kiri0110/can_test/OneDrive/ドキュメント/Python/Attracts/can.md

sudo slcand -o -c -s2 /dev/ttyACM0 can0
sudo ip link set can0 up
