kiri0110/can_test/OneDrive/ドキュメント/PCB/446CAN_2-20240912T023128Z-001/446CAN_2/446CAN_2_readme.docx

446CAN_2_readme

kikad 7.0で作成（6.0では開けない）

446ハンバーガーの上側の基板

秋月B基板、両面ノンスルーホールで実装

真ん中のI2CピンはLCD用

RJ45の5VコネクタがST MorphoのU5Vピンと繋がっていないので、被覆線等でジャンプして適当に繋ぐ
