kiri0110/can_test/OneDrive/ドキュメント/PCB/303_MCv3_6-20240912T023711Z-001/303_MCv3_6/303MCv3.6パーツリスト.xlsx

品名 | 記号 | 定数・型番 | 数量 | 注 | 備考1 | 備考2
抵抗 | R1, R6, R8 |  | 3 | 1 | 黄色LEDに対応 | 2012又は1608サイズ
抵抗 | R2, R3, R9 |  | 3 | 1 | 緑色LEDに対応 | 2012又は1608サイズ
抵抗 | R4, R5, R7 |  | 3 | 1 | 赤色LEDに対応 | 2012又は1608サイズ
抵抗 | R10 | 120R | 1 |  | CANバスの終端抵抗用 | 2012又は1608サイズ
抵抗 | R11 |  | 1 | 1 | パイロットLED | 2012又は1608サイズ
抵抗 | R12 | 200R | 1 |  | Rg | 2012又は1608サイズ
抵抗 | R13 | 2K | 1 |  | Rgs | 2012又は1608サイズ
抵抗 | R14 | 100R | 1 |  | NRSTプルアップ | 2012又は1608サイズ
LED | D1, D6, D8 | 黄 | 3
LED | D4, D5, D7 | 赤 | 3
LED | D2, D3, D9 | 緑 | 3
LED | D10 | 青 | 1
ショットキーバリアダイオード | D11 | CUHS20S30 | 1
積層セラミックコンデンサ | C1 | 0.1uF | 1
FET | Q1 | 2N7002K | 1
スピーカー | LS1 | UGCT7525AN4 | 1
タクトスイッチ | SW1, SW2, SW3, SW5 | SKRPACE010 | 4 |  | 2.55N品を使用すること
スライドスイッチ | SW4 | SSSS213202 | 1
マイコン | U1 | NUCLEO-F303K8 | 1
CANトランシーバ | U2 | MCP2561-E-P | 1
ピンソケット | U1 | 分割ロングピンソケット42p | 19x2コマ
ICソケット | U2 | 2x4 | 1
ピンヘッダ | J1, J7, J13, J17 | ピンヘッダ2p | 2x4コマ
XAコネクタ | J2, J8, J11, J16 | B02B-XASK | 4
XAコネクタ | J5, J6, J14, J15 | B03B-XASK | 4
XAコネクタ | J3, J4 | B05B-XASK | 2
LANコネクタ | J9, J10 | RJ-45 | 2
GHコネクタ | J12, J18 | SM02B-GHS | 2
