kiri0110/can_test/OneDrive/ドキュメント/PCB/303_MCv3_6-20240912T023711Z-001/303_MCv3_6/BottomCase_C.stl

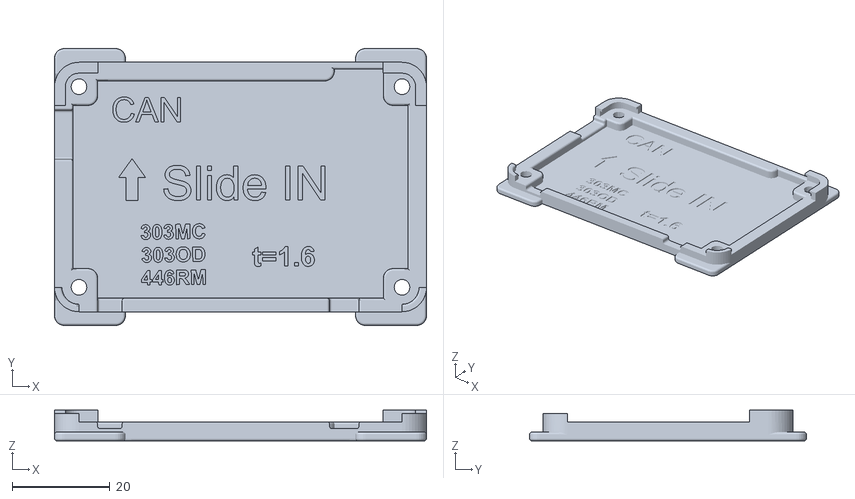
[picture p1: CAD file, 2025-05-26]
OneDrive/ドキュメント/PCB/303_MCv3_6-20240912T023711Z-001/303_MCv3_6/BottomCase_C.stl
76.0 x 56.6 x 6.30
