kiri0110/can_test/(list of files, cad)

Other CAD files:
OneDrive/ドキュメント/PCB/303_MCv3_6-20240912T023711Z-001/303_MCv3_6/BottomCase_Slide v3.step
