kiri0110/can_test/OneDrive/ドキュメント/PCB/303_MCv3_6-20240912T023711Z-001/303_MCv3_6/303MCv3.6_sch.pdf

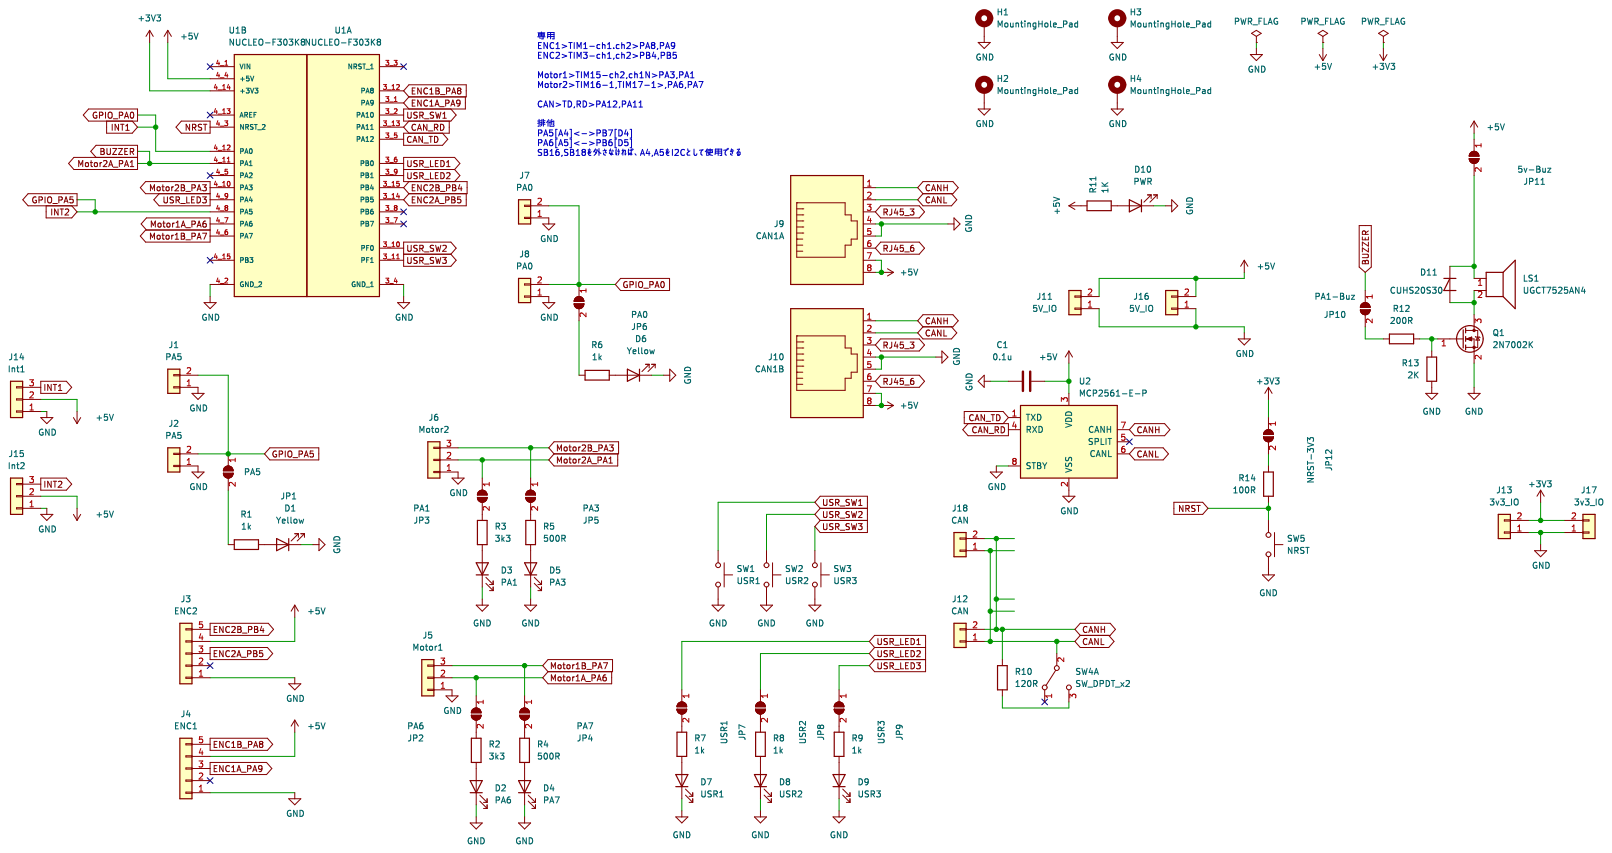
[picture p2: page 1]
