kiri0110/can_test/OneDrive/ドキュメント/PCB/446RMv1.0-20240913T070430Z-001/446RMv1.0/446_CAN_Robomaster_new.kicad_pcb

## KiCad design OneDrive/ドキュメント/PCB/446RMv1.0-20240913T070430Z-001/446RMv1.0/446_CAN_Robomaster_new.kicad_pcb (2025-05-26)

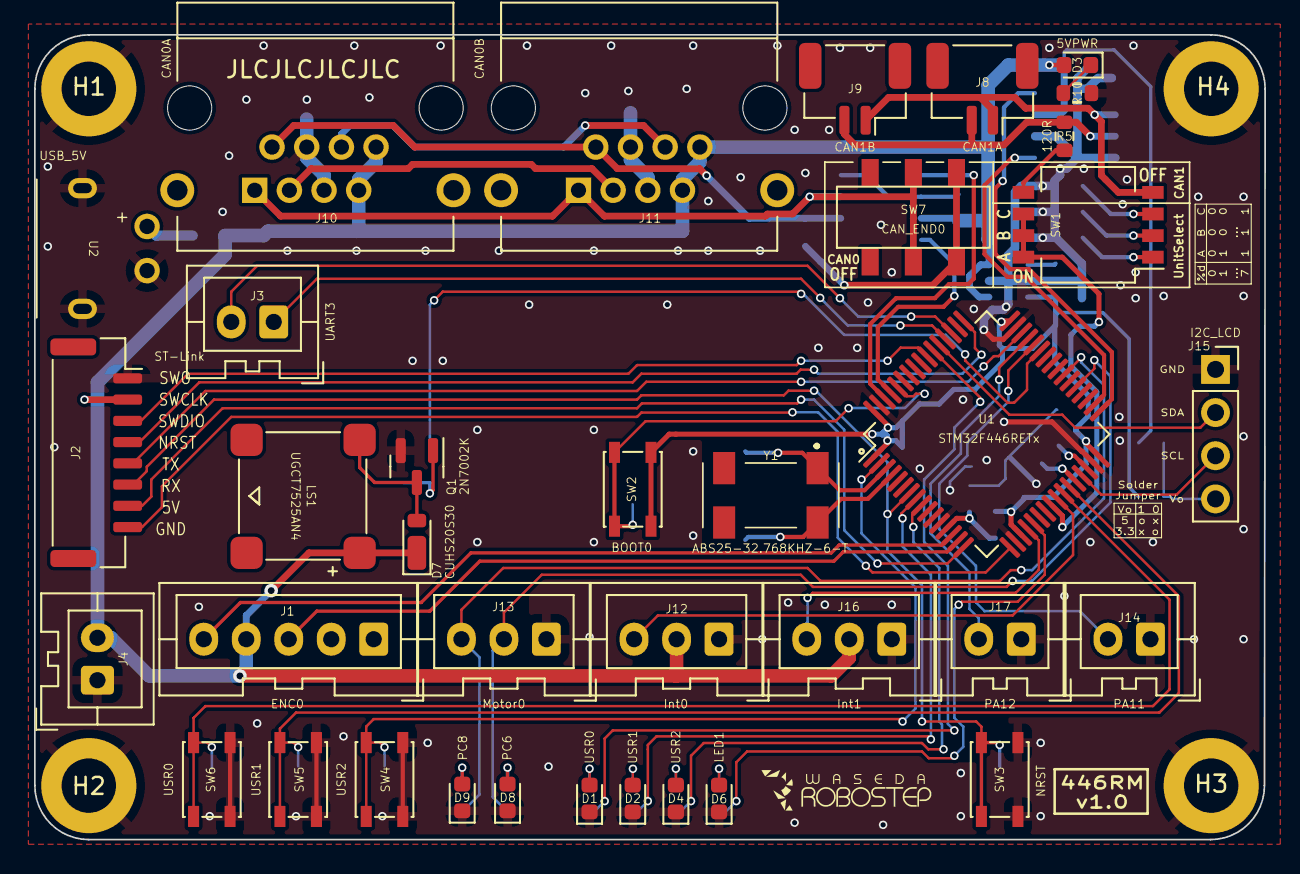
[picture p3: board 446_CAN_Robomaster_new.kicad_pcb from above]

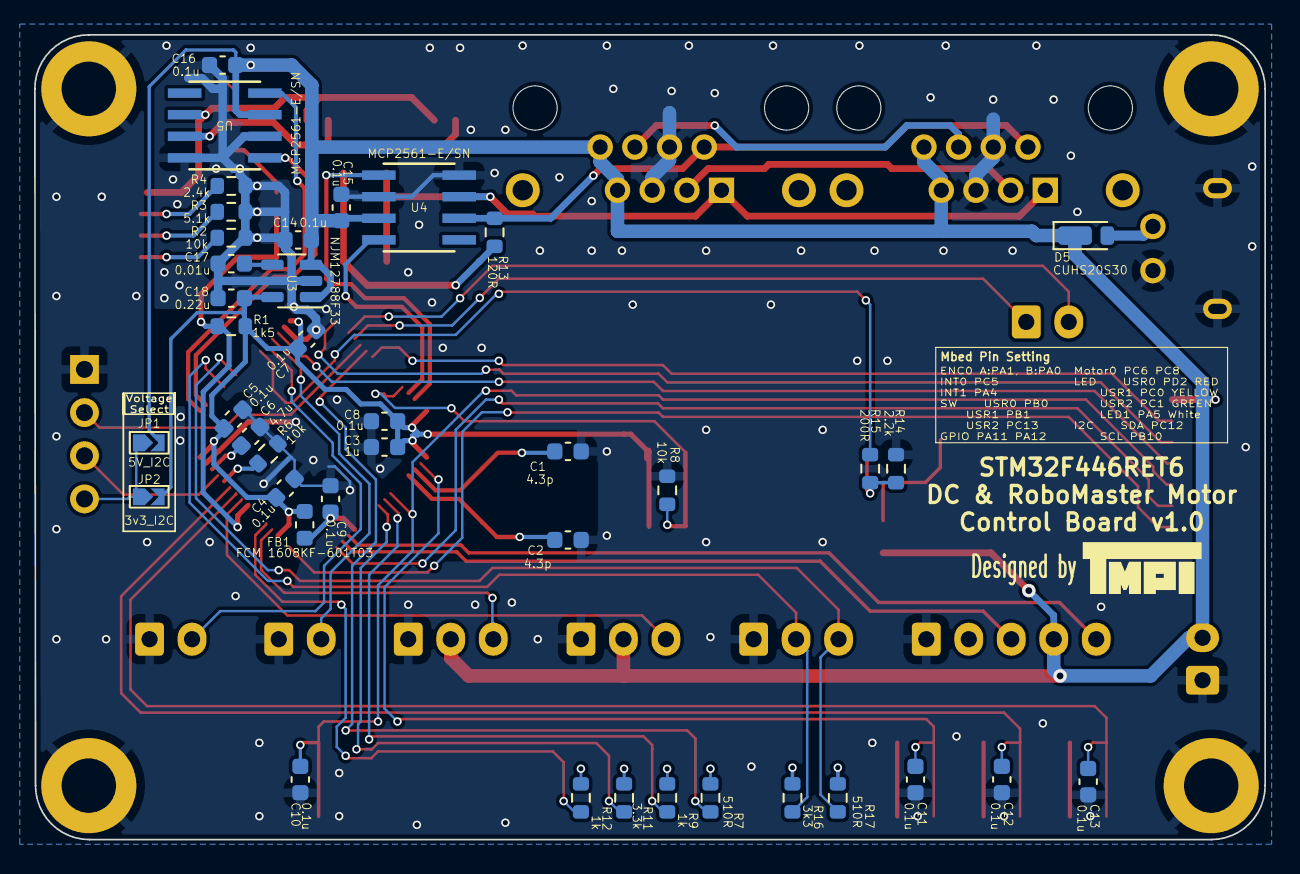
[picture p4: board 446_CAN_Robomaster_new.kicad_pcb from below]

Board: 2 copper layers, 72.4 x 47.3 mm, 80 parts (40 on the bottom side), 63 nets.

Parts:
C1, C2: 4.3p; C_0603_1608Metric
C3: 1u; C_0603_1608Metric
C4, C5, C7, C8, C9, C10, C11, C12, C13, C14, C15, C16: 0.1u; C_0603_1608Metric
C6: 4.7u; C_0603_1608Metric
C17: 0.01u; C_0603_1608Metric
C18: 0.22u; C_0603_1608Metric
D1: USR0; LED_0603_1608Metric
D2: USR1; LED_0603_1608Metric
D3: 5VPWR; LED_0603_1608Metric
D4: USR2; LED_0603_1608Metric
D5, D7: CUHS20S30; D_TUMD2
D6: LED1; LED_0603_1608Metric
D8: PC6; LED_0603_1608Metric
D9: PC8; LED_0603_1608Metric
FB1: FerriteBead; L_0603_1608Metric
H1, H2, H3, H4: H; MountingHole_3.2mm_M3_DIN965_Pad
J1: ENC0; JST_XA_B05B-XASK-1_1x05_P2.50mm_Vertical
J2: ST-Link; JST_GH_SM08B-GHS-TB_1x08-1MP_P1.25mm_Horizontal
J3: UART3; JST_XA_B02B-XASK-1_1x02_P2.50mm_Vertical
J4: 5V_IO; JST_XA_B02B-XASK-1_1x02_P2.50mm_Vertical
J8: CAN1A; JST_GH_SM02B-GHS-TB_1x02-1MP_P1.25mm_Horizontal_Handsolder
J9: CAN1B; JST_GH_SM02B-GHS-TB_1x02-1MP_P1.25mm_Horizontal_Handsolder
J10: CAN0A; Kai_LAN_RJ45_Neltron_Industrial_7810-8P8C
J11: CAN0B; Kai_LAN_RJ45_Neltron_Industrial_7810-8P8C
J12: Int0; JST_XA_B03B-XASK-1_1x03_P2.50mm_Vertical
J13: Motor0; JST_XA_B03B-XASK-1_1x03_P2.50mm_Vertical
J14: PA11; JST_XA_B02B-XASK-1_1x02_P2.50mm_Vertical
J15: I2C_LCD; PinSocket_1x04_P2.54mm_Vertical
J16: Int1; JST_XA_B03B-XASK-1_1x03_P2.50mm_Vertical
J17: PA12; JST_XA_B02B-XASK-1_1x02_P2.50mm_Vertical
JP1: 5V_I2C; solderbridge
JP2: 3v3_I2C; solderbridge
LS1: UGCT7525AN4
Q1: 2N7002K; SOT-23
R1: 1k5; R_0603_1608Metric
R2, R6, R8: 10k; R_0603_1608Metric
R3: 5.1k; R_0603_1608Metric
R4: 2.4k; R_0603_1608Metric
R5, R13: 120R; R_0603_1608Metric
R7, R17: 510R; R_0603_1608Metric
R9, R10, R12: 1k; R_0603_1608Metric
R11: 3.3k; R_0603_1608Metric
R14: 2.2k; R_0603_1608Metric
R15: 200R; R_0603_1608Metric
R16: 3k3; R_0603_1608Metric
SW1: UnitSelect; SW_DIP_SPSTx04_Slide_KingTek_DSHP04TS_W7.62mm_P1.27mm
SW2: BOOT0; SW_SPST_PTS810_HandSolder
SW3: NRST; SW_SPST_PTS810_HandSolder
SW4: USR2; SW_SPST_PTS810_HandSolder
SW5: USR1; SW_SPST_PTS810_HandSolder
SW6: USR0; SW_SPST_PTS810_HandSolder
SW7: CAN_END0; slide_SW
U1: STM32F446RETx; LQFP-64_10x10mm_P0.5mm
U2: USB_5V; aki_USB_mB_PWR
U3: NJM12788F33; SOT-23-5
U4, U5: MCP2561-E/SN; SOIC8-N_MC_MCH
Y1: ABS25-32.768KHZ-6-T; ABS2532768KHZT

Connections:
5V_CAN0: C14.1, C15.2, C16.2, D3.2 (A), D5.1 (K), D7.1 (K), J1.4, J2.2, J4.2, J10.7, J10.8, J11.7, J11.8, J12.2, J16.2, JP1.2 (B), LS1.1, U3.1 (VIN), U3.3 (CONTROL), U4.3 (VDD), U5.3 (VDD)
+3.3VA: C9.1, FB1.2, U1.13 (VDDA)
+3V3: C3.2, C4.1, C5.2, C7.1, C8.1, C18.1, FB1.1, JP2.2 (B), R1.1, SW2.1, U1.1 (VBAT), U1.19 (VDD), U1.32 (VDD), U1.48 (VDD), U1.64 (VDD), U3.5 (VOUT)
BOOT0: R8.2, SW2.2, U1.60 (BOOT0)
BUZZER: R15.1, U1.43 (PA10)
CAN_0+: J10.1, J11.1, SW7.2 (B), U4.7 (CANH)
CAN_0-: J10.2, J11.2, R13.2, U4.6 (CANL)
CAN_1+: J8.2, J9.2, R5.1, U5.7 (CANH)
CAN_1-: J8.1, J9.1, SW1.4, U5.6 (CANL)
CAN_RD_0: U1.61 (PB8), U4.4 (RXD)
CAN_RD_1: U1.33 (PB12), U5.4 (RXD)
CAN_TD_0: U1.62 (PB9), U4.1 (TXD)
CAN_TD_1: U1.34 (PB13), U5.1 (TXD)
ENC0A_PA1: J1.3, U1.15 (PA1)
ENC0B_PA0: J1.5, U1.14 (PA0)
GND: C1.2, C2.2, C3.1, C4.2, C5.1, C6.2, C7.2, C8.2, C9.2, C10.2, C11.2, C12.2, C13.2, C14.2, C15.1, C16.1, C17.2, C18.2, D1.1 (K), D2.1 (K), D4.1 (K), D6.1 (K), D8.1 (K), D9.1 (K), H1.1, H2.1, H3.1, H4.1, J1.1, J2.1, J4.1, J10.4, J10.5, J11.4, J11.5, J12.1, J13.1, J14.1, J15.1, J16.1, J17.1, Q1.2 (S), R2.2, R3.1, R4.1, R6.1, R8.1, R10.2, R14.1, SW3.2, SW4.2, SW5.2, SW6.2, U1.12 (VSSA), U1.18 (VSS), U1.31 (VSS), U1.47 (VSS), U1.63 (VSS), U2.2 (GND), U2.3 (Shield), U3.2 (GND), U4.2 (VSS), U4.8 (STBY), U5.2 (VSS), U5.8 (STBY)
GPIO_PA11: J14.2, U1.44 (PA11)
GPIO_PA12: J17.2, U1.45 (PA12)
I2C2_SCL: J15.3, U1.29 (PB10)
I2C2_SDA: J15.2, U1.53 (PC12)
INT0: J12.3, U1.25 (PC5)
INT1: J16.3, U1.20 (PA4)
LED1: R12.1, U1.21 (PA5)
Motor0CCW_PC8: J13.3, R17.1, U1.39 (PC8)
Motor0CW_PC6: J13.2, R16.1, U1.37 (PC6)
NRST: C10.1, J2.6, SW3.1, U1.7 (NRST)
unnamed: D1.2 (A), R7.2
unnamed: D2.2 (A), R9.2
unnamed: D3.1 (K), R10.1
unnamed: D4.2 (A), R11.2
unnamed: D5.2 (A), U2.1 (VBUS)
unnamed: D6.2 (A), R12.2
unnamed: D7.2 (A), LS1.2, Q1.3 (D)
unnamed: D8.2 (A), R16.2
unnamed: D9.2 (A), R17.2
unnamed: J15.4, JP1.1 (A), JP2.1 (A)
unnamed: Q1.1 (G), R14.2, R15.2
unnamed: R2.1, SW1.1
unnamed: R3.2, SW1.2
unnamed: R4.2, SW1.3
unnamed: R5.2, SW1.5
unnamed: R13.1, SW7.3 (C)
unnamed: R6.2, U1.28 (PB2)
unnamed: C6.1, U1.30 (VCAP_1)
unnamed: C17.1, U3.4 (CS)
OSCL_IN: C1.1, U1.3 (PC14), Y1.1 (CRYSTAL_1)
OSCL_OUT: C2.1, U1.4 (PC15), Y1.4 (CRYSTAL_2)
RJ45_3_0: J10.3, J11.3
RJ45_6_0: J10.6, J11.6
SWCLK: J2.4, U1.49 (PA14)
SWDIO: J2.5, U1.46 (PA13)
SWO: J2.3, U1.55 (PB3)
UART3_RX: J3.1, U1.52 (PC11)
UART3_TX: J3.2, U1.51 (PC10)
USR_LED0: R7.1, U1.54 (PD2)
USR_LED1: R9.1, U1.8 (PC0)
USR_LED2: R11.1, U1.9 (PC1)
USR_SW0: C13.1, SW6.1, U1.26 (PB0)
USR_SW1: C12.1, SW5.1, U1.27 (PB1)
USR_SW2: C11.1, SW4.1, U1.2 (PC13)
UnitSelect: R1.2, SW1.6, SW1.7, SW1.8, U1.24 (PC4)
VCP_RX: J2.8, U1.17 (PA3)
VCP_TX: J2.7, U1.16 (PA2)
