kiri0110/can_test/OneDrive/ドキュメント/PCB/446CAN_2-20240912T023128Z-001/446CAN_2/446CAN_2.kicad_pcb

## KiCad design OneDrive/ドキュメント/PCB/446CAN_2-20240912T023128Z-001/446CAN_2/446CAN_2.kicad_pcb (2025-05-26)

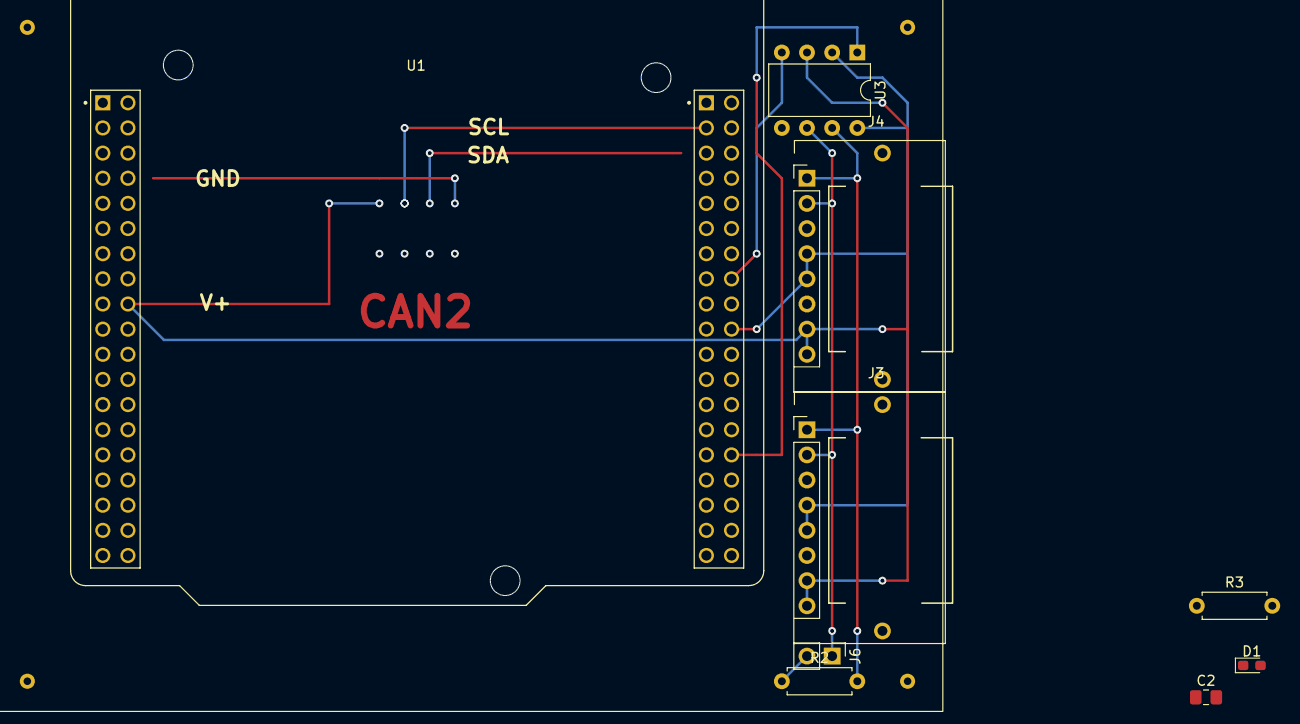
[picture p5: board 446CAN_2.kicad_pcb from above]

Board: 2 copper layers, 9 parts (0 on the bottom side), 8 nets.

Parts:
C2: 0.1u; C_0805_2012Metric_Pad1.18x1.45mm_HandSolder
D1: PWR; LED_0603_1608Metric_Pad1.05x0.95mm_HandSolder
J3: CAN1A; LAN-DIP_in
J4: CAN1B; LAN-DIP_in
J6: Conn_01x02; PinHeader_1x02_P2.54mm_Vertical
R2: 120R; R_Axial_DIN0207_L6.3mm_D2.5mm_P7.62mm_Horizontal
R3: 1K; R_Axial_DIN0207_L6.3mm_D2.5mm_P7.62mm_Horizontal
U1: NUCLEO-F446RE
U3: MCP2561-E-P; DIP-8_W7.62mm

Connections:
+5V: C2.2, J3.7, J3.8, J4.7, J4.8, R3.1, U1.CN7_18 (CN7_+5V), U3.3 (VDD)
CAN2H: J3.1, J4.1, R2.2, U3.7 (CANH)
CAN2L: J3.2, J4.2, J6.1, U3.6 (CANL)
CAN2_RD: U1.CN10_16 (PB12), U3.4 (RXD)
CAN2_TD: U1.CN10_30 (PB13), U3.1 (TXD)
GND: C2.1, D1.1 (K), J3.4, J3.5, J4.4, J4.5, U1.CN7_8 (CN7_GND), U1.CN7_19 (CN7_GND), U1.CN7_20 (CN7_GND), U1.CN7_22 (CN7_GND), U1.CN10_9 (CN10_GND), U1.CN10_20 (CN10_GND), U3.2 (VSS), U3.8 (STBY)
unnamed: D1.2 (A), R3.2
unnamed: J6.2, R2.1
